Tanishq4009/stealth-detection/firmware/stealth/secrets.example.h

#pragma once

// ---------- Wi-Fi ----------
#define WIFI_SSID                 "YOUR_WIFI_NAME"
#define WIFI_PASSWORD             "YOUR_WIFI_PASSWORD"

// ---------- Cloudinary ----------
#define CLOUDINARY_CLOUD_NAME     "YOUR_CLOUD_NAME"
#define CLOUDINARY_UPLOAD_PRESET  "YOUR_UNSIGNED_UPLOAD_PRESET"

// ---------- OneSignal ----------
#define ONESIGNAL_APP_ID          "YOUR_ONESIGNAL_APP_ID"
#define ONESIGNAL_REST_API_KEY    "YOUR_ONESIGNAL_REST_API_KEY"
